upenn-embedded/helix-vault/images/400x400.jpg

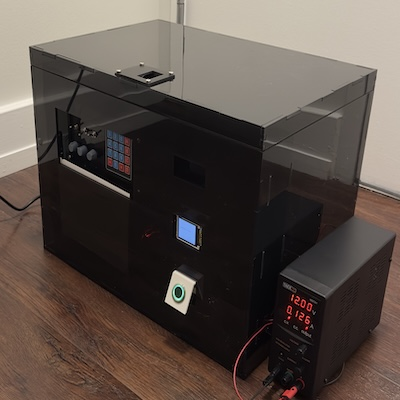
images/400x400.jpg
