upenn-embedded/helix-vault/code/c_code/LCD_GFX_new.h

/*
Header file for graphic controls
*/

#include <avr/io.h>
#include "ASCII_LUT.h"
// #include "ASCII_LUT_10x16.h"

#ifndef LCD_GFX_new_H_
#define LCD_GFX_new_H_

// define basic colors:
#define	BLACK     0x0000
#define WHITE     0xFFFF
#define	BLUE      0x001F
#define	RED       0xF800
#define	GREEN     0x07E0
#define CYAN      0x07FF
#define MAGENTA   0xF81F
#define YELLOW    0xFFE0

// initialize functions (most of them I created in lab 4 - except rgb565, drawPixel, and drawChar which I created today (11/16))
uint16_t rgb565(uint8_t red, uint8_t green, uint8_t blue);
void draw_pixel(uint8_t x, uint8_t y, uint16_t color);
void draw_char(uint8_t x, uint8_t y, uint16_t character, uint16_t fColor, uint16_t bColor);
void draw_char16(uint8_t x, uint8_t y, uint16_t character, uint16_t fColor, uint16_t bColor);
void LCD_drawCircle(uint8_t x0, uint8_t y0, uint8_t radius,uint16_t color);
void LCD_drawLine(short x0,short y0,short x1,short y1,uint16_t c);
void LCD_drawBlock(uint8_t x0, uint8_t y0, uint8_t x1, uint8_t y1,uint16_t color);
void LCD_setScreen(uint16_t color);
void LCD_drawString(uint8_t x, uint8_t y, char* str, uint16_t fg, uint16_t bg, uint8_t fontSize);
void LCD_ID_verified(void);
void LCD_combination(void);
void LCD_pin(void);
#endif /* LCD_GFX_new_H_ */
